thieu-b55/4-in-a-row-3D/README.md

# 4-in-a-row-3D
3D version 3D version of the game 4 in a row

4 in a row 3D with 125 (5x5x5) WS2812B LEDS

see included video
